eloisagc-classsroom/proyectofinal2024-1-AlanCrespoV/README.md

Review Assignment Due Date (https://classroom.github.com/a/v-p78NmD)
# starter_template_pse
Este repositorio consta del código y documentación relacionado al proyecto de la materia de sistemas empotrados, dentro de este podemos encontrar el PDf que describe el desarrollo del proyecto y todo el código relacionado al funcionamiento de esto. Desglosando lo que encontraremos en este repositorio tenemos
\Documentacion\ProyectoEmpotrados: PDF en el que se describe la forma de recrear este proyecto, asi como lista de materiales y descripciones de las complicaciones encontradas durante el desarrollo de este.
\Código\proyecto_cs: Esta carpeta contiene el código principal del proyecto, es el único necesario para el funcionamiento del prototipo
\Código\pruebas_fotos_buena: Esta carpeta contiene código que ofrece una forma de testear el correcto funcionamiento de la placa de receptores
\Código\pruebaFototransistores: Esta carpeta contiene código para probar tus fototransistores, sea como sea, este esta diseñado para entradas digitales, por lo que si tus componentes son iguales a los descritos en ProyectoEmpotrados.pdf no te será de utilidad
\Código\pruenba_pantalla: Código para probar la pantalla LCD. Dependiendo de tu modelo de pantalla puede que tengas que modificarlo
